Ernesto311203/PE1_Wearable/README.md

# PE1_Wearable
Codigos utilizados para el arduino y creación de la aplicación.
13/08/2025: Se adicionan esquemáticos, footprints, símbolos y modelos 3D para KiCAD (trabajado en KiCAD 9).
