Ernesto311203/PE1_Wearable/Mezzanine_PCB_B2B/Pinout_NINA.png

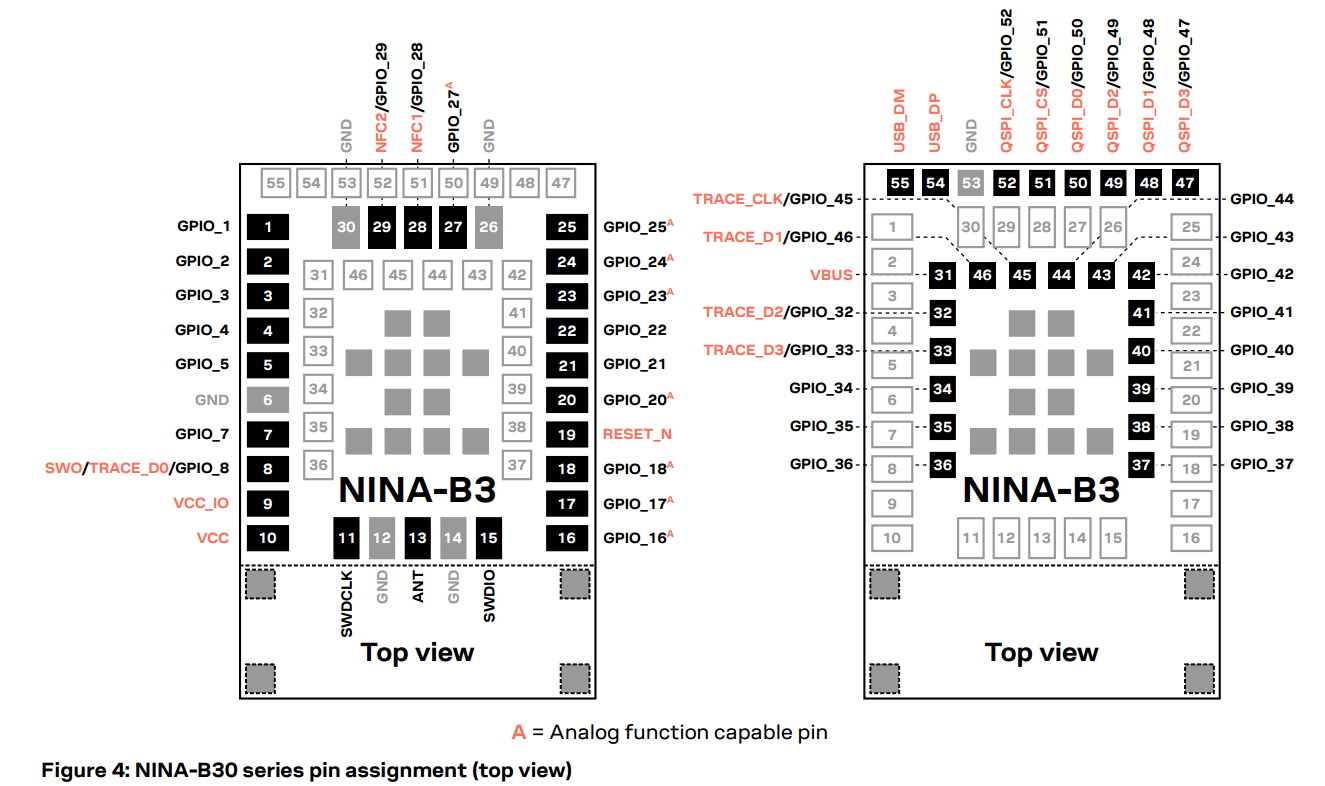
Mezzanine_PCB_B2B/Pinout_NINA.png
