Ernesto311203/PE1_Wearable/Mezzanine_PCB_B2B/Switch_image.png

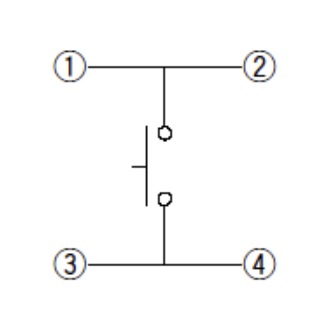
Mezzanine_PCB_B2B/Switch_image.png
