Ernesto311203/PE1_Wearable/Mezzanine_PCB_B2B/bom-JLCPCB Assembly Order.xls

JLCPCB BOM Tool - BOM Matching
BOM name：bom-JLCPCB Assembly Order.xlsx |  |  | Download Time：2025-08-21 18:07:15 |  |  |  | * Our matching results are updated in real-time, but stock and prices may change. If it's been over 24 hours, please re-match before placing your order.
PCB Assembled Qty：5 |  |  | Est. Total Price：75.5885
Your BOM |  |  |  |  | Matched Parts |  |  |  |  |  |  | Order Information
Top Designator | Bottom Designator | Comment | Footprint | JLCPCB Part # | Matches | Part # | Manufacturer | Footprint | Description | Category | Warning | JLCPCB Part # | Product link | Lib Type | Qty | Source | Total Price ($)
BT1 |  | 2996 | BAT_2996 |  | Select by System | 2996 | Keystone | - | - Battery connector ROHS | Battery Connector |  | C5370874 | https://jlcpcb.com/partdetail/Keystone-2996/C5370874 | Extended | 2 | 2 JLCPCB | 1.305
C1,C10,C11,C12,C9 |  | 10u | 0402 |  | Unconfirmed | CL05A106MQ5NUNC | Samsung Electro-Mechanics | 0402 | 10uF 6.3V X5R ±20% 0402 Multilayer Ceramic Capacitors MLCC - SMD/SMT ROHS | Multilayer Ceramic Capacitors MLCC - SMD/SMT | 1.The comment (CL05A106MQ5NUNC) of this part does not match the one (10u) provided in your BOM. Please confirm; | C15525 | https://jlcpcb.com/partdetail/16204-CL05A106MQ5NUNC/C15525 | Basic | 20 | 20 JLCPCB | 0.118
C2,C4,C6 |  | 100n | 0603 |  | Unconfirmed | CC0603KRX7R9BB104 | YAGEO | 0603 | 100nF 50V X7R ±10% 0603 Multilayer Ceramic Capacitors MLCC - SMD/SMT ROHS | Multilayer Ceramic Capacitors MLCC - SMD/SMT | 1.The comment (CC0603KRX7R9BB104) of this part does not match the one (100n) provided in your BOM. Please confirm; | C14663 | https://jlcpcb.com/partdetail/YAGEO-CC0603KRX7R9BB104/C14663 | Basic | 20 | 20 JLCPCB | 0.046
C3,C5,C7 |  | 10n | 0603 |  | Unconfirmed | 0603B103K500NT | FH (Guangdong Fenghua Advanced Tech) | 0603 | 10nF 50V X7R ±10% 0603 Multilayer Ceramic Capacitors MLCC - SMD/SMT ROHS | Multilayer Ceramic Capacitors MLCC - SMD/SMT | 1.The comment (0603B103K500NT) of this part does not match the one (10n) provided in your BOM. Please confirm; | C57112 | https://jlcpcb.com/partdetail/58143-0603B103K500NT/C57112 | Basic | 20 | 20 JLCPCB | 0.044
C13,C14 |  | 1u | 0402 |  | Unconfirmed | CL05A105KA5NQNC | Samsung Electro-Mechanics | 0402 | 1uF 25V X5R ±10% 0402 Multilayer Ceramic Capacitors MLCC - SMD/SMT ROHS | Multilayer Ceramic Capacitors MLCC - SMD/SMT | 1.The comment (CL05A105KA5NQNC) of this part does not match the one (1u) provided in your BOM. Please confirm; | C52923 | https://jlcpcb.com/partdetail/53938-CL05A105KA5NQNC/C52923 | Basic | 20 | 20 JLCPCB | 0.06
C15 |  | 220n(5%) | 0402 |  | Unconfirmed | GRM155R61A224JE19D | Murata Electronics | 0402 | 10V 220nF X5R ±5% 0402 Multilayer Ceramic Capacitors MLCC - SMD/SMT ROHS | Multilayer Ceramic Capacitors MLCC - SMD/SMT | 1.The comment (GRM155R61A224JE19D) of this part does not match the one (220n(5%)) provided in your BOM. Please confirm; | C882536 | https://jlcpcb.com/partdetail/946643-GRM155R61A224JE19D/C882536 | Extended | 20 | 20 JLCPCB | 0.592
C16,C18,C36,C38,C40,C8 |  | 10u(5%) | 0402 |  | Select by Customer | GRM155R61A106ME44D | Murata Electronics | 0402 | 10V 10uF X5R ±20% 0402 Multilayer Ceramic Capacitors MLCC - SMD/SMT ROHS | Multilayer Ceramic Capacitors MLCC - SMD/SMT |  | C77000 | https://jlcpcb.com/partdetail/MurataElectronics-GRM155R61A106ME44D/C77000 | Extended | 24 | 24 JLCPCB | 0.2712
C17,C19,C21,C22,C23,C28,C32,C33,C35,C37,C39,C41,C42,C43,C44 |  | 100n(5%) | 0402 |  | Unconfirmed | CC0402JRX7R9BB104 | YAGEO | 0402 | 100nF 50V X7R ±5% 0402 Multilayer Ceramic Capacitors MLCC - SMD/SMT ROHS | Multilayer Ceramic Capacitors MLCC - SMD/SMT | 1.The comment (CC0402JRX7R9BB104) of this part does not match the one (100n(5%)) provided in your BOM. Please confirm; | C5182432 | https://jlcpcb.com/partdetail/YAGEO-CC0402JRX7R9BB104/C5182432 | Extended | 42 | 42 JLCPCB | 0.1848
C20,C31 |  | 2.2u(5%) | 0402 |  | Select by Customer | GRM155R61A225KE95D | Murata Electronics | 0402 | 10V 2.2uF X5R ±10% 0402 Multilayer Ceramic Capacitors MLCC - SMD/SMT ROHS | Multilayer Ceramic Capacitors MLCC - SMD/SMT |  | C77002 | https://jlcpcb.com/partdetail/MurataElectronics-GRM155R61A225KE95D/C77002 | Extended | 20 | 20 JLCPCB | 0.082
C24,C25,C26,C27,C29,C30 |  | 1u(5%) | 0402 |  | Unconfirmed | C0402X5R6R3-105JNP | Venkel | 0402 | 1uF 6.3V X5R ±5% 0402 Multilayer Ceramic Capacitors MLCC - SMD/SMT ROHS | Multilayer Ceramic Capacitors MLCC - SMD/SMT | 1.The comment (C0402X5R6R3-105JNP) of this part does not match the one (1u(5%)) provided in your BOM. Please confirm; | C3892343 | https://jlcpcb.com/partdetail/Venkel-C0402X5R6R3105JNP/C3892343 | Extended | 22 | 22 JLCPCB | 0.3608
C34 |  | 3.9p(5%) | 0402 |  | Select by Customer | GJM1555C1H3R9WB01D | Murata Electronics | 0402 | 3.9pF 50V C0G 0402 Multilayer Ceramic Capacitors MLCC - SMD/SMT ROHS | Multilayer Ceramic Capacitors MLCC - SMD/SMT |  | C88893 | https://jlcpcb.com/partdetail/MurataElectronics-GJM1555C1H3R9WB01D/C88893 | Extended | 20 | 20 JLCPCB | 0.774
D1,D2 |  | SML-P11UTT86R | LED_SML-P11UTT86R |  | Select by System | SML-P11UTT86R | ROHM Semicon | 0402 | -40℃~+85℃ 1.8V 1mA 2.5mcd 50mW 621nm Orange Red 0402 LED Indication - Discrete ROHS | LED Indication - Discrete |  | C510300 | https://jlcpcb.com/partdetail/ROHMSemicon-SMLP11UTT86R/C510300 | Extended | 7 | 7 JLCPCB | 0.7427
IC1 |  | TMP117AIDRVR | SON65P200X200X80-7N |  | Select by System | TMP117AIDRVR | Texas Instruments | WDFN-6-EP(2x2) | WDFN-6-EP(2x2) Temperature Sensors ROHS | Temperature Sensors |  | C699536 | https://jlcpcb.com/partdetail/TexasInstruments-TMP117AIDRVR/C699536 | Extended | 2 | 2 JLCPCB | 2.211
J1 |  | 702461001 | CONN_7024610xx_MOL |  | Select by System | 702461001 | MOLEX | - | - Wire To Board Connector ROHS | Wire To Board Connector |  | C588425 | https://jlcpcb.com/partdetail/MOLEX-702461001/C588425 | Extended | 2 | 2 JLCPCB | 1.956
J2 |  | Conn_02x02_Counter_Clockwise | PinHeader_2x02_P1.27mm_Vertical |  | Select by Customer | X1321WV-2x02J-C30D23 | XKB Connection | 插件,P=1.27mm | -40℃~+105℃ 1.27mm 1.27mm 1A 1mm 2 250V 2x2P 4P Black Brass Gold Pin Header Plugin,P=1.27mm Pin Headers ROHS | Pin Headers |  | C2881784 | https://jlcpcb.com/partdetail/XKBConnection-X1321WV_2x02JC30D23/C2881784 | Extended | 3 | 3 JLCPCB | 0.168
J3,J4 |  | 203389-0363 | 2033890363 |  | Select by System | 2033890363 | MOLEX | SMD,P=0.35mm | 0.35mm 2 36P Gold Surface Mount,Vertical SMD,P=0.35mm Board-to-Board and Backplane Connector ROHS | Board-To-Board And Backplane Connector |  | C5491435 | https://jlcpcb.com/partdetail/MOLEX-2033890363/C5491435 | Extended | 4 | 4 JLCPCB | 5.394
L1 |  | MLZ2012M100HT000 | INDC2012X145N |  | Select by System | MLZ2012M100HT000 | TDK | 0805 | 10uH 200mA 680mΩ ±20% 0805 Inductors (SMD) ROHS | Inductors (SMD) |  | C88172 | https://jlcpcb.com/partdetail/TDK-MLZ2012M100HT000/C88172 | Extended | 6 | 6 JLCPCB | 0.2748
L2 |  | LBM2016T6R8J | INDC2016X180N_6_8uH |  | Select by Customer | MLZ2012M6R8WT000 | TDK | 0805 | 220mA 400mΩ 6.8uH ±20% 0805 Inductors (SMD) ROHS | Inductors (SMD) | 1.The comment (MLZ2012M6R8WT000) of this part does not match the one (LBM2016T6R8J) provided in your BOM. Please confirm; | C383410 | https://jlcpcb.com/partdetail/TDK-MLZ2012M6R8WT000/C383410 | Extended | 6 | 6 JLCPCB | 0.3006
 | LED1,LED3,LED4 | SFH_2202 | SFH2202 |  | Select by Customer | SFH 2200 | OSRAM Opto Semicon | SMD,4x5.1mm | SMD,4x5.1mm Photodiodes ROHS | Photodiodes | 1.The comment (SFH 2200) of this part does not match the one (SFH_2202) provided in your BOM. Please confirm; | C2900212 | https://jlcpcb.com/partdetail/OSRAM_OptoSemicon-SFH2200/C2900212 | Extended | 6 | 6 JLCPCB | 5.715
 | LED2 | SFH_7050A | SFH7050A |  | Unconfirmed | SFH 7050A | OSRAM Opto Semicon | SMD-8P | -40℃~+85℃ 1.3V 120° 2mW/sr@20mA 5V 60mA 940nm SMD-8P Infrared LED Emitters ROHS | Infrared LED Emitters | 1.The comment (SFH 7050A) of this part does not match the one (SFH_7050A) provided in your BOM. Please confirm; | C7357545 | https://jlcpcb.com/partdetail/OSRAM_OptoSemicon-SFH7050A/C7357545 | Extended | 2 | 2 JLCPCB | 6.132
Q2 |  | NX6008NBKSX | SOT65P210X110-6N |  | Select by System | NX6008NBKSX | Nexperia | TSSOP-6 | -55℃~+150℃ 2 N-Channel 2.7Ω@4.5V,300mA 220mA 260mW 27pF@30V 2pF@30V 60V 700pC@4.5V 900mV TSSOP-6 MOSFETs ROHS | MOSFETs |  | C3291378 | https://jlcpcb.com/partdetail/Nexperia-NX6008NBKSX/C3291378 | Extended | 5 | 5 JLCPCB | 0.379
R1 |  | 39R | 0402 |  | Unconfirmed | RC0402FR-0739RL | YAGEO | 0402 | -55℃~+155℃ 39Ω 50V 62.5mW Thick Film Resistor ±1% ±100ppm/℃ 0402 Chip Resistor - Surface Mount ROHS | Chip Resistor - Surface Mount | 1.The comment (RC0402FR-0739RL) of this part does not match the one (39R) provided in your BOM. Please confirm; | C185420 | https://jlcpcb.com/partdetail/YAGEO-RC0402FR0739RL/C185420 | Extended | 20 | 20 JLCPCB | 0.012
R2,R3 |  | 1k | 0402 |  | Unconfirmed | 0402WGF1001TCE | UNI-ROYAL(Uniroyal Elec) | 0402 | -55℃~+155℃ 1kΩ 50V 62.5mW Thick Film Resistor ±1% ±100ppm/℃ 0402 Chip Resistor - Surface Mount ROHS | Chip Resistor - Surface Mount | 1.The comment (0402WGF1001TCE) of this part does not match the one (1k) provided in your BOM. Please confirm; | C11702 | https://jlcpcb.com/partdetail/12256-0402WGF1001TCE/C11702 | Basic | 20 | 20 JLCPCB | 0.01
R4 |  | 0R | 0402 |  | Unconfirmed | 0402WGF0000TCE | UNI-ROYAL(Uniroyal Elec) | 0402 | -55℃~+155℃ 0Ω 50V 62.5mW Thick Film Resistor ±1% ±800ppm/℃ 0402 Chip Resistor - Surface Mount ROHS | Chip Resistor - Surface Mount | 1.The comment (0402WGF0000TCE) of this part does not match the one (0R) provided in your BOM. Please confirm; | C17168 | https://jlcpcb.com/partdetail/17853-0402WGF0000TCE/C17168 | Basic | 20 | 20 JLCPCB | 0.01
R5 |  | 10k | 0402 |  | Unconfirmed | 0402WGF1002TCE | UNI-ROYAL(Uniroyal Elec) | 0402 | -55℃~+155℃ 10kΩ 50V 62.5mW Thick Film Resistor ±1% ±100ppm/℃ 0402 Chip Resistor - Surface Mount ROHS | Chip Resistor - Surface Mount | 1.The comment (0402WGF1002TCE) of this part does not match the one (10k) provided in your BOM. Please confirm; | C25744 | https://jlcpcb.com/partdetail/26487-0402WGF1002TCE/C25744 | Basic | 20 | 20 JLCPCB | 0.01
R6 |  | 162k(1%) | 0402 |  | Unconfirmed | RT0402BRD07162KL | YAGEO | 0402 | -55℃~+155℃ 162kΩ 50V 62.5mW Thin Film Resistor ±0.1% ±25ppm/℃ 0402 Chip Resistor - Surface Mount ROHS | Chip Resistor - Surface Mount | 1.The comment (RT0402BRD07162KL) of this part does not match the one (162k(1%)) provided in your BOM. Please confirm; | C852551 | https://jlcpcb.com/partdetail/YAGEO-RT0402BRD07162KL/C852551 | Extended | 20 | 20 JLCPCB | 0.454
R7 |  | 180k(1%) | 0402 |  | Unconfirmed | FRC0402F1803TS | FOJAN | 0402 | -55℃~+155℃ 180kΩ 50V 62.5mW Thick Film Resistor ±1% ±100ppm/℃ 0402 Chip Resistor - Surface Mount ROHS | Chip Resistor - Surface Mount | 1.The comment (FRC0402F1803TS) of this part does not match the one (180k(1%)) provided in your BOM. Please confirm; | C2909325 | https://jlcpcb.com/partdetail/FOJAN-FRC0402F1803TS/C2909325 | Extended | 20 | 20 JLCPCB | 0.01
R8 |  | 540k(1%) | 0402 |  | Select by Customer | 0402WGF5363TCE | UNI-ROYAL(Uniroyal Elec) | 0402 | -55℃~+155℃ 50V 536kΩ 62.5mW Thick Film Resistor ±1% ±100ppm/℃ 0402 Chip Resistor - Surface Mount ROHS | Chip Resistor - Surface Mount |  | C68457 | https://jlcpcb.com/partdetail/69559-0402WGF5363TCE/C68457 | Extended | 20 | 20 JLCPCB | 0.006
R11,R9 |  | 1Meg(1%) | 0402 |  | Unconfirmed | FRC0402F1004TS | FOJAN | 0402 | -55℃~+155℃ 1MΩ 50V 62.5mW Thick Film Resistor ±1% ±100ppm/℃ 0402 Chip Resistor - Surface Mount ROHS | Chip Resistor - Surface Mount | 1.The comment (FRC0402F1004TS) of this part does not match the one (1Meg(1%)) provided in your BOM. Please confirm; | C2909328 | https://jlcpcb.com/partdetail/FOJAN-FRC0402F1004TS/C2909328 | Extended | 20 | 20 JLCPCB | 0.01
R12 |  | 0R(1%) | 0402 |  | Unconfirmed | SCR0402F0R | VO | 0402 | -55℃~+155℃ 0Ω 50V 62.5mW Thick Film Resistor ±1% 0402 Chip Resistor - Surface Mount ROHS | Chip Resistor - Surface Mount | 1.The comment (SCR0402F0R) of this part does not match the one (0R(1%)) provided in your BOM. Please confirm; | C5140078 | https://jlcpcb.com/partdetail/VO-SCR0402F0R/C5140078 | Extended | 20 | 20 JLCPCB | 0.008
R14,R15,R16 |  | 5k1(1%) | 0402 |  | Unconfirmed | RT0402BRD075K1L | YAGEO | 0402 | -55℃~+155℃ 5.1kΩ 50V 62.5mW Thin Film Resistor ±0.1% ±25ppm/℃ 0402 Chip Resistor - Surface Mount ROHS | Chip Resistor - Surface Mount | 1.The comment (RT0402BRD075K1L) of this part does not match the one (5k1(1%)) provided in your BOM. Please confirm; | C852856 | https://jlcpcb.com/partdetail/YAGEO-RT0402BRD075K1L/C852856 | Extended | 20 | 20 JLCPCB | 0.376
R13_2 |  | 750k(1%) | 0402 |  | Select by Customer | RC0402FR-07750KL | YAGEO | 0402 | -55℃~+155℃ 50V 62.5mW 750kΩ Thick Film Resistor ±1% ±100ppm/℃ 0402 Chip Resistor - Surface Mount ROHS | Chip Resistor - Surface Mount |  | C137937 | https://jlcpcb.com/partdetail/YAGEO-RC0402FR07750KL/C137937 | Extended | 20 | 20 JLCPCB | 0.012
S1,S2 |  | SKRPABE010 | SKRPABE010 |  | Select by System | SKRPABE010 | ALPSALPINE | SMD | 16V 2.5mm 3.2mm 4.2mm 50mA Oval Button SPST Surface Mount,Vertical SMD Tactile Switches ROHS | Tactile Switches |  | C115360 | https://jlcpcb.com/partdetail/ALPSALPINE-SKRPABE010/C115360 | Extended | 8 | 8 JLCPCB | 0.5472
S3 |  | PCM12SMTR | PCM12SMTR |  | Select by System | PCM12SMTR | C&K | SMD | -20℃~+85℃ 6V PC Pin Rectangular Columnar SPDT Surface Mount,Vertical SMD Slide Switches ROHS | Slide Switches |  | C221841 | https://jlcpcb.com/partdetail/CK-PCM12SMTR/C221841 | Extended | 2 | 2 JLCPCB | 2.328
U3,U4 |  | TPS61071DDCR | SOT95P280X110-6N |  | Select by System | TPS61071DDCR | Texas Instruments | SOT-23-6 | -40℃~+85℃@(TA) 1 1.2MHz 1.8V~5.5V 500mA 900mV~5.5V Adjustable Boost Boost Built-in Yes SOT-23-6 DC-DC Converters ROHS | DC-DC Converters |  | C188637 | https://jlcpcb.com/partdetail/TexasInstruments-TPS61071DDCR/C188637 | Extended | 4 | 4 JLCPCB | 1.758
U5 |  | TPS73215MDBVREP | DBV5 |  | Select by Customer | TPS73215DCQR | Texas Instruments | SOT-223-6 | -40℃~+125℃@(Tj) 1 1.5V 250mA 30uVrms 400uA 40mV@(250mA) 5.5V 58dB@(100Hz) Fixed Over Current Protection Positive SOT-223-6 Voltage Regulators - Linear, Low Drop Out (LDO) Regulators ROHS | Voltage Regulators - Linear, Low Drop Out (LDO) Regulators |  | C2865336 | https://jlcpcb.com/partdetail/TexasInstruments-TPS73215DCQR/C2865336 | Extended | 2 | 2 JLCPCB | 4.29
U6,U7 |  | TPS7A2018PDBVR | DBV0005A-IPC_A |  | Select by System | TPS7A2018PDBVR | Texas Instruments | SOT-23-5L | -40℃~+125℃@(Tj) 1 1.8V 10uVrms 200mV@(300mA) 300mA 6.5uA 6V 92dB@(1kHz) Fixed Positive Under Voltage Lockout SOT-23-5L Voltage Regulators - Linear, Low Drop Out (LDO) Regulators ROHS | Voltage Regulators - Linear, Low Drop Out (LDO) Regulators |  | C963430 | https://jlcpcb.com/partdetail/TexasInstruments-TPS7A2018PDBVR/C963430 | Extended | 4 | 4 JLCPCB | 0.7904
U8 |  | TPS7A2033PDBVR | DBV0005A-IPC_A |  | Select by System | TPS7A2033PDBVR | Texas Instruments | SOT-23-5 | -40℃~+125℃@(Tj) 1 10uVrms 140mV@(300mA) 3.3V 300mA 65dB@(100kHz) 6V 8.5uA Fixed Over Current Protection Positive SOT-23-5 Voltage Regulators - Linear, Low Drop Out (LDO) Regulators ROHS | Voltage Regulators - Linear, Low Drop Out (LDO) Regulators |  | C2862740 | https://jlcpcb.com/partdetail/TexasInstruments-TPS7A2033PDBVR/C2862740 | Extended | 5 | 5 JLCPCB | 0.859
U9 |  | ADP7118AUJZ-R7 | UJ_5_ADI |  | Select by System | ADP7118AUJZ-R7 | Analog Devices | TSOT-5 | -40℃~+125℃@(Tj) 1 1.2V~19.8V 11uVrms 140uA 200mA 20V 420mV@(200mA) 88dB@(10kHz) Adjustable Over Current Protection Positive TSOT-5 Voltage Regulators - Linear, Low Drop Out (LDO) Regulators ROHS | Voltage Regulators - Linear, Low Drop Out (LDO) Regulators |  | C514355 | https://jlcpcb.com/partdetail/AnalogDevices-ADP7118AUJZR7/C514355 | Extended | 2 | 2 JLCPCB | 3.336
U10 |  | NINA-B306-00B | XCVR_NINA-B306-00B |  | Select by System | NINA-B306-00B | U-BLOX | SMD-55P | SMD-55P Bluetooth Modules ROHS | Bluetooth Modules |  | C6127317 | https://jlcpcb.com/partdetail/UBLOX-NINA_B30600B/C6127317 | Extended | 2 | 2 JLCPCB | 33.264
Y1 |  | SIT9003AC-23-18EB-24.000000T | OSC_SIT9003AC-23-18EB-24.000000T |  | Select by Customer | X322512MSB4SI | YXC Crystal Oscillators | SMD3225-4P | -40℃~+85℃ 12MHz 20pF Crystal Oscillator ±10ppm ±20ppm SMD3225-4P Crystals ROHS | Crystals | 1.The comment (X322512MSB4SI) of this part does not match the one (SIT9003AC-23-18EB-24.000000T) provided in your BOM. Please confirm; | C9002 | https://jlcpcb.com/partdetail/YXC_CrystalOscillators-X322512MSB4SI/C9002 | Basic | 6 | 6 JLCPCB | 0.387
R13 |  | 500k(1%) | 0402 |  | No matches | No Part Selected
