Ernesto311203/PE1_Wearable/Side_PCB/PCB/production/bom-JLCPCB Assembly Order.xls

JLCPCB BOM Tool - BOM Matching
BOM name：bom-JLCPCB Assembly Order.xlsx |  |  | Download Time：2025-08-20 04:47:17 |  |  |  | * Our matching results are updated in real-time, but stock and prices may change. If it's been over 24 hours, please re-match before placing your order.
PCB Assembled Qty：5 |  |  | Est. Total Price：51.7565
Your BOM |  |  |  |  | Matched Parts |  |  |  |  |  |  | Order Information
Top Designator | Bottom Designator | Comment | Footprint | JLCPCB Part # | Matches | Part # | Manufacturer | Footprint | Description | Category | Warning | JLCPCB Part # | Product link | Lib Type | Qty | Source | Total Price ($)
C1,C32,C33,C4 |  | 100n(5%) | 0402 |  | Unconfirmed | CC0402JRX7R9BB104 | YAGEO | 0402 | 100nF 50V X7R ±5% 0402 Multilayer Ceramic Capacitors MLCC - SMD/SMT ROHS | Multilayer Ceramic Capacitors MLCC - SMD/SMT | 1.The comment (CC0402JRX7R9BB104) of this part does not match the one (100n(5%)) provided in your BOM. Please confirm; | C5182432 | https://jlcpcb.com/partdetail/YAGEO-CC0402JRX7R9BB104/C5182432 | Extended | 20 | 20 JLCPCB | 0.088
C2 |  | 4.7u(5%) | 0402 |  | Select by Customer | CL05A475MP5NRNC | Samsung Electro-Mechanics | 0402 | 10V 4.7uF X5R ±20% 0402 Multilayer Ceramic Capacitors MLCC - SMD/SMT ROHS | Multilayer Ceramic Capacitors MLCC - SMD/SMT |  | C23733 | https://jlcpcb.com/partdetail/24469-CL05A475MP5NRNC/C23733 | Basic | 20 | 20 JLCPCB | 0.096
C3 |  | 10n(5%) | 0402 |  | Unconfirmed | 0402B103J500NT | FH (Guangdong Fenghua Advanced Tech) | 0402 | 10nF 50V X7R ±5% 0402 Multilayer Ceramic Capacitors MLCC - SMD/SMT ROHS | Multilayer Ceramic Capacitors MLCC - SMD/SMT | 1.The comment (0402B103J500NT) of this part does not match the one (10n(5%)) provided in your BOM. Please confirm; | C2894324 | https://jlcpcb.com/partdetail/3128847-0402B103J500NT/C2894324 | Extended | 20 | 20 JLCPCB | 0.034
C10,C11,C12,C15,C16,C17,C18,C7,C8,C9 |  | 1u(5%) | 0402 |  | Unconfirmed | C0402X5R6R3-105JNP | Venkel | 0402 | 1uF 6.3V X5R ±5% 0402 Multilayer Ceramic Capacitors MLCC - SMD/SMT ROHS | Multilayer Ceramic Capacitors MLCC - SMD/SMT | 1.The comment (C0402X5R6R3-105JNP) of this part does not match the one (1u(5%)) provided in your BOM. Please confirm; | C3892343 | https://jlcpcb.com/partdetail/Venkel-C0402X5R6R3105JNP/C3892343 | Extended | 30 | 30 JLCPCB | 0.492
C34 |  | 3.9p(5%) | 0402 |  | Select by Customer | 0402CG3R9C500NT | FH (Guangdong Fenghua Advanced Tech) | 0402 | 3.9pF 50V C0G 0402 Multilayer Ceramic Capacitors MLCC - SMD/SMT ROHS | Multilayer Ceramic Capacitors MLCC - SMD/SMT |  | C1566 | https://jlcpcb.com/partdetail/1918-0402CG3R9C500NT/C1566 | Extended | 20 | 20 JLCPCB | 0.022
D1 |  | PRTR5V0U2X | SOT-143 |  | Select by System | PRTR5V0U2X | TECH PUBLIC | SOT-143 | -55℃~+125℃ 0.8pF 100W 15V 3.0 5V 6.5V 6A 80nA ESD IEC 61000-4-2 Unidirectional SOT-143 ESD and Surge Protection (TVS/ESD) ROHS | ESD And Surge Protection (TVS/ESD) |  | C2827688 | https://jlcpcb.com/partdetail/TECHPUBLIC-PRTR5V0U2X/C2827688 | Extended | 6 | 6 JLCPCB | 0.354
FB1,FB2 |  | PE-0805FB121ST | BEADC2112X105N |  | Select by Customer | GZ2012D121TF | Sunlord | 0805 | 1 120Ω@100MHz 150mΩ 800mA ±25% 0805 Ferrite Beads ROHS | Ferrite Beads |  | C5671 | https://jlcpcb.com/partdetail/Sunlord-GZ2012D121TF/C5671 | Extended | 20 | 20 JLCPCB | 0.264
IC1,IC2 |  | TLV75101PDSQR | SON40P200X200X80-11N |  | Select by System | TLV75101PDSQR | Texas Instruments | WSON-10-EP(2x2) | -40℃~+125℃@(Tj) 130mV@(500mA) 2 25uA 30uVrms 500mA 50dB@(1kHz) 550mV~5.5V 6V Adjustable Positive Under Voltage Lockout WSON-10-EP(2x2) Voltage Regulators - Linear, Low Drop Out (LDO) Regulators ROHS | Voltage Regulators - Linear, Low Drop Out (LDO) Regulators |  | C2861335 | https://jlcpcb.com/partdetail/TexasInstruments-TLV75101PDSQR/C2861335 | Extended | 5 | 5 JLCPCB | 1.571
J1 |  | SHF-110-01-L-D-TH | SAMTEC_SHF-110-01-L-D-TH |  | Select by System | SHF-110-01-L-D-TH | Samtec | 插件 | -55℃~+125℃ 1.27mm 2 Phosphor Bronze Through Hole Tin Plugin Wire To Board Connector ROHS | Wire To Board Connector |  | C17455319 | https://jlcpcb.com/partdetail/Samtec-SHF_110_01_L_DTH/C17455319 | Extended | 2 | 2 JLCPCB | 9.291
J2 |  | Conn_02x02_Counter_Clockwise | PinHeader_2x02_P1.27mm_Vertical |  | Select by Customer | X1321WV-2x02J-C30D23 | XKB Connection | 插件,P=1.27mm | -40℃~+105℃ 1.27mm 1.27mm 1A 1mm 2 250V 2x2P 4P Black Brass Gold Pin Header Plugin,P=1.27mm Pin Headers ROHS | Pin Headers |  | C2881784 | https://jlcpcb.com/partdetail/XKBConnection-X1321WV_2x02JC30D23/C2881784 | Extended | 3 | 3 JLCPCB | 0.168
J3 |  | USB_C_Receptacle16P | USB_C_Receptacle16P_Molex |  | Select by Customer | 2171790001 | MOLEX | SMD | SMD USB Connectors ROHS | USB Connectors |  | C3197684 | https://jlcpcb.com/partdetail/MOLEX-2171790001/C3197684 | Extended | 2 | 2 JLCPCB | 1.299
J6 |  | Conn_01x06_Pin | PinHeader_1x06_P1.27mm_Vertical |  | Select by Customer | PZ127-1-06-Z | HCTL | 插件,P=1.27mm | -40℃~+105℃ 1 1.27mm 1A 1mm 1x6P 2.4mm 3.8mm 6P Black Brass Pin Header Through Hole Plugin,P=1.27mm Pin Headers ROHS | Pin Headers |  | C5372829 | https://jlcpcb.com/partdetail/HCTL-PZ127_1_06Z/C5372829 | Extended | 2 | 2 JLCPCB | 0.1302
LED5,LED6 |  | SML-P11UTT86R | KDZLV100 |  | Select by System | SML-P11UTT86R | ROHM Semicon | 0402 | -40℃~+85℃ 1.8V 1mA 2.5mcd 50mW 621nm Orange Red 0402 LED Indication - Discrete ROHS | LED Indication - Discrete |  | C510300 | https://jlcpcb.com/partdetail/ROHMSemicon-SMLP11UTT86R/C510300 | Extended | 7 | 7 JLCPCB | 0.7427
Q1 |  | NX138AKSX | NX138AKSX |  | Select by Customer | NX6008NBKSX | Nexperia | TSSOP-6 | -55℃~+150℃ 2 N-Channel 2.7Ω@4.5V,300mA 220mA 260mW 27pF@30V 2pF@30V 60V 700pC@4.5V 900mV TSSOP-6 MOSFETs ROHS | MOSFETs | 1.The comment (NX6008NBKSX) of this part does not match the one (NX138AKSX) provided in your BOM. Please confirm; | C3291378 | https://jlcpcb.com/partdetail/Nexperia-NX6008NBKSX/C3291378 | Extended | 5 | 5 JLCPCB | 0.379
R1,R2 |  | 5k1(1%) | 0402 |  | Unconfirmed | RT0402BRD075K1L | YAGEO | 0402 | -55℃~+155℃ 5.1kΩ 50V 62.5mW Thin Film Resistor ±0.1% ±25ppm/℃ 0402 Chip Resistor - Surface Mount ROHS | Chip Resistor - Surface Mount | 1.The comment (RT0402BRD075K1L) of this part does not match the one (5k1(1%)) provided in your BOM. Please confirm; | C852856 | https://jlcpcb.com/partdetail/YAGEO-RT0402BRD075K1L/C852856 | Extended | 20 | 20 JLCPCB | 0.376
R4,R6 |  | 220k(1%) | 0402 |  | Select by Customer | RC0402FR-07330KL | YAGEO | 0402 | -55℃~+155℃ 330kΩ 50V 62.5mW Thick Film Resistor ±1% ±100ppm/℃ 0402 Chip Resistor - Surface Mount ROHS | Chip Resistor - Surface Mount | 1.The comment (RC0402FR-07330KL) of this part does not match the one (220k(1%)) provided in your BOM. Please confirm; | C138006 | https://jlcpcb.com/partdetail/YAGEO-RC0402FR07330KL/C138006 | Extended | 20 | 20 JLCPCB | 0.012
R7,R9 |  | 1.2Meg(1%) | 0402 |  | Unconfirmed | FRC0402F1204TS | FOJAN | 0402 | -55℃~+155℃ 1.2MΩ 50V 62.5mW Thick Film Resistor ±1% ±100ppm/℃ 0402 Chip Resistor - Surface Mount ROHS | Chip Resistor - Surface Mount | 1.The comment (FRC0402F1204TS) of this part does not match the one (1.2Meg(1%)) provided in your BOM. Please confirm; | C2960795 | https://jlcpcb.com/partdetail/FOJAN-FRC0402F1204TS/C2960795 | Extended | 20 | 20 JLCPCB | 0.012
R10,R8 |  | 240k(1%) | 0402 |  | Unconfirmed | FRC0402F2403TS | FOJAN | 0402 | -55℃~+155℃ 240kΩ 50V 62.5mW Thick Film Resistor ±1% ±100ppm/℃ 0402 Chip Resistor - Surface Mount ROHS | Chip Resistor - Surface Mount | 1.The comment (FRC0402F2403TS) of this part does not match the one (240k(1%)) provided in your BOM. Please confirm; | C2909338 | https://jlcpcb.com/partdetail/FOJAN-FRC0402F2403TS/C2909338 | Extended | 20 | 20 JLCPCB | 0.008
R12 |  | 0R(1%) | 0402 |  | Unconfirmed | SCR0402F0R | VO | 0402 | -55℃~+155℃ 0Ω 50V 62.5mW Thick Film Resistor ±1% 0402 Chip Resistor - Surface Mount ROHS | Chip Resistor - Surface Mount | 1.The comment (SCR0402F0R) of this part does not match the one (0R(1%)) provided in your BOM. Please confirm; | C5140078 | https://jlcpcb.com/partdetail/VO-SCR0402F0R/C5140078 | Extended | 20 | 20 JLCPCB | 0.008
R13,R3,R5 |  | 500k(1%) | 0402 |  | Select by Customer | RC0402FR-07750KL | YAGEO | 0402 | -55℃~+155℃ 50V 62.5mW 750kΩ Thick Film Resistor ±1% ±100ppm/℃ 0402 Chip Resistor - Surface Mount ROHS | Chip Resistor - Surface Mount |  | C137937 | https://jlcpcb.com/partdetail/YAGEO-RC0402FR07750KL/C137937 | Extended | 20 | 20 JLCPCB | 0.012
S2 |  | SKRPABE010 | SKRPABE010 |  | Select by System | SKRPABE010 | ALPSALPINE | SMD | 16V 2.5mm 3.2mm 4.2mm 50mA Oval Button SPST Surface Mount,Vertical SMD Tactile Switches ROHS | Tactile Switches |  | C115360 | https://jlcpcb.com/partdetail/ALPSALPINE-SKRPABE010/C115360 | Extended | 6 | 6 JLCPCB | 0.4104
S3 |  | PCM12SMTR | PCM12SMTR |  | Select by System | PCM12SMTR | C&K | SMD | -20℃~+85℃ 6V PC Pin Rectangular Columnar SPDT Surface Mount,Vertical SMD Slide Switches ROHS | Slide Switches |  | C221841 | https://jlcpcb.com/partdetail/CK-PCM12SMTR/C221841 | Extended | 2 | 2 JLCPCB | 2.328
U2 |  | TPS7A2018PDBVR | DBV0005A-IPC_A |  | Select by System | TPS7A2018PDBVR | Texas Instruments | SOT-23-5L | -40℃~+125℃@(Tj) 1 1.8V 10uVrms 200mV@(300mA) 300mA 6.5uA 6V 92dB@(1kHz) Fixed Positive Under Voltage Lockout SOT-23-5L Voltage Regulators - Linear, Low Drop Out (LDO) Regulators ROHS | Voltage Regulators - Linear, Low Drop Out (LDO) Regulators |  | C963430 | https://jlcpcb.com/partdetail/TexasInstruments-TPS7A2018PDBVR/C963430 | Extended | 2 | 2 JLCPCB | 0.3952
U10 |  | NINA-B306-00B | XCVR_NINA-B306-00B |  | Select by System | NINA-B306-00B | U-BLOX | SMD-55P | SMD-55P Bluetooth Modules ROHS | Bluetooth Modules |  | C6127317 | https://jlcpcb.com/partdetail/UBLOX-NINA_B30600B/C6127317 | Extended | 2 | 2 JLCPCB | 33.264
