Ernesto311203/PE1_Wearable/Side_PCB/nRF52840_Design.pdf

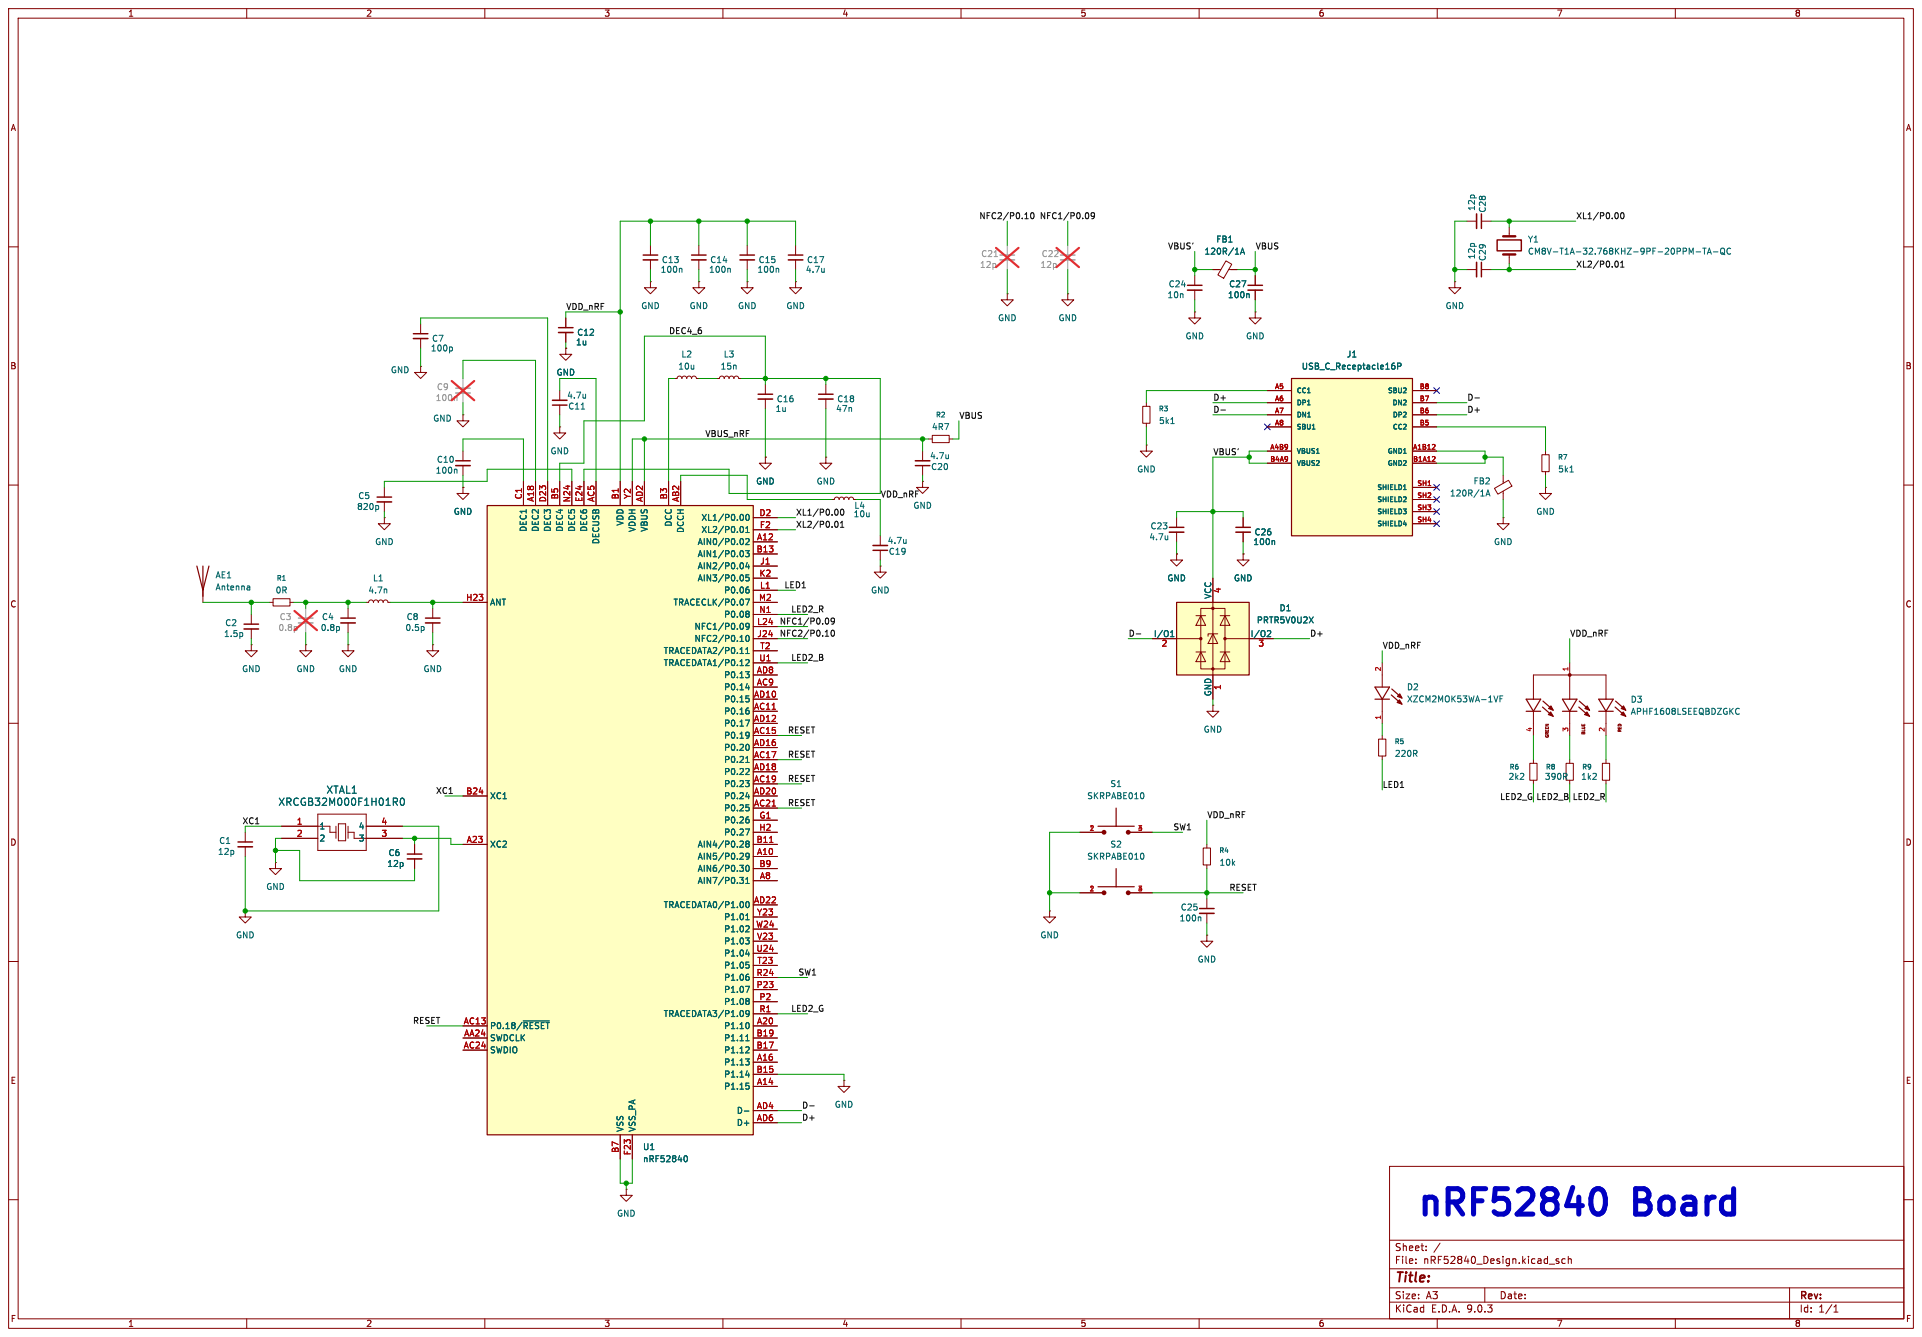
[picture p3: page 1]

Id: 1/1 Title: File: nRF52840_Design.kicad_sch Sheet: /
