Ernesto311203/PE1_Wearable/Mezzanine_PCB_B2B/WearablePCB_v2.pdf

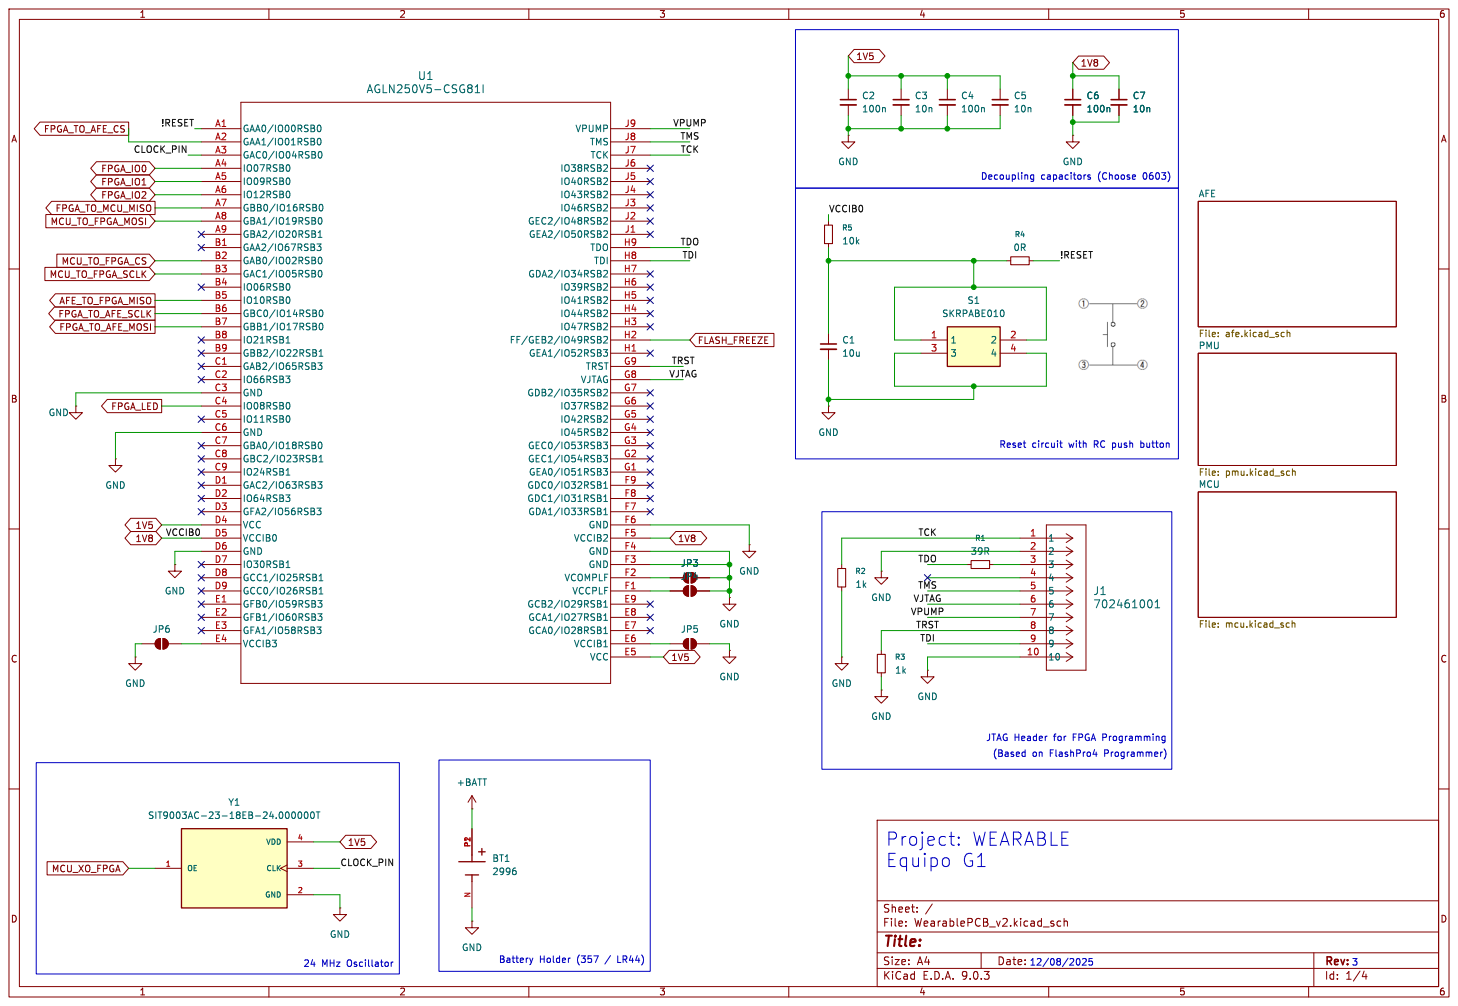
[picture p4: page 1]

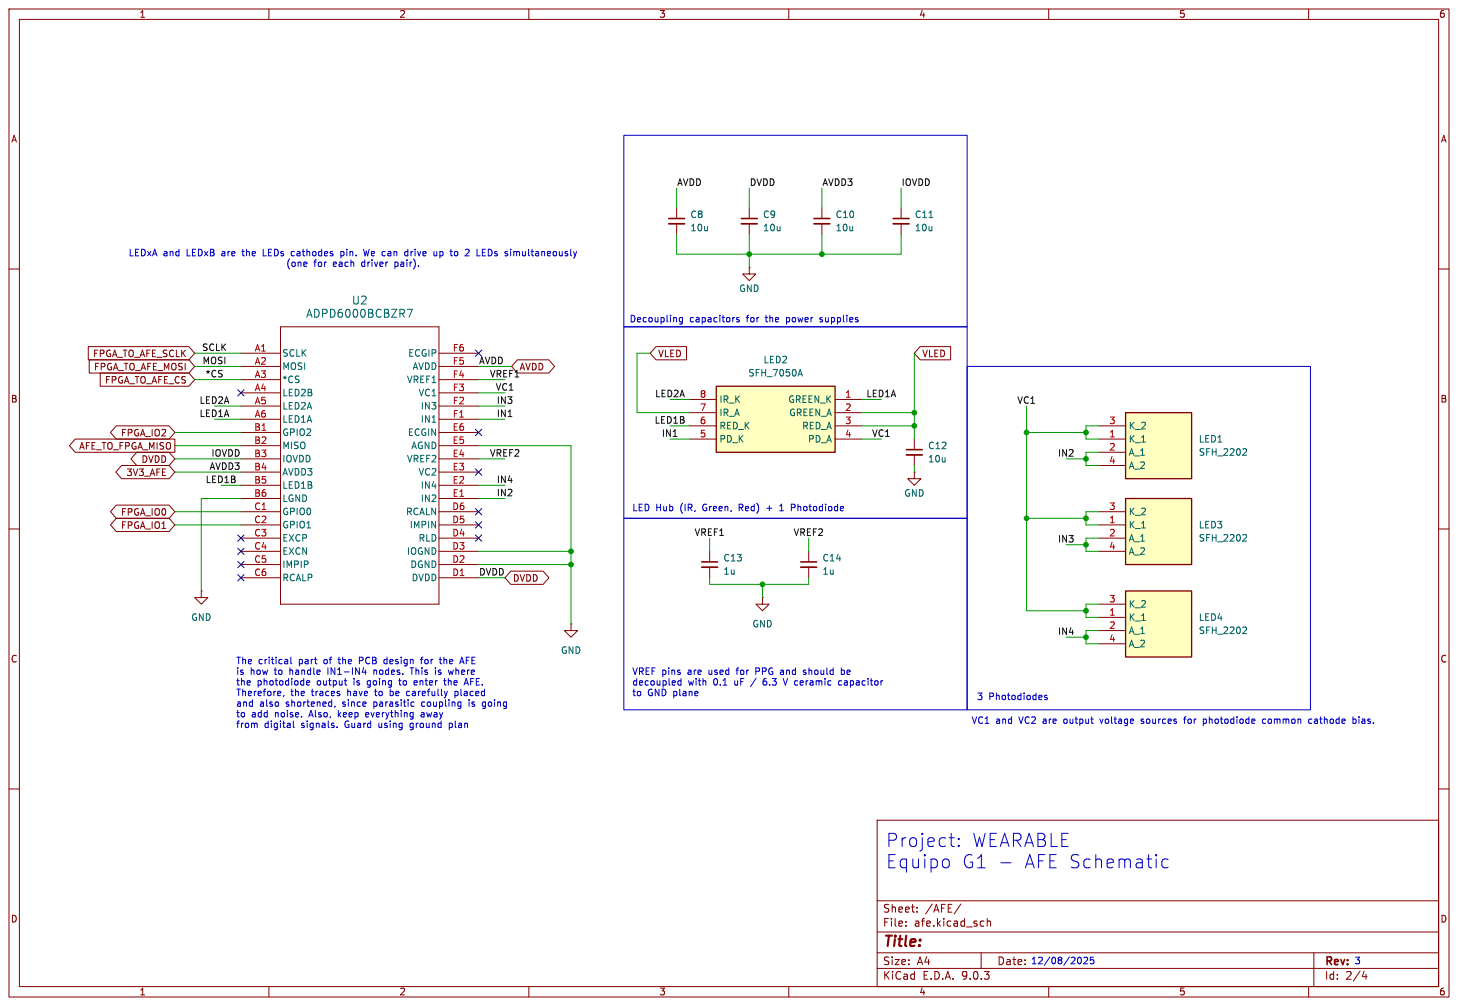
[picture p5: page 2]

Id: 2/4 Title: File: afe.kicad_sch Sheet: /AFE/

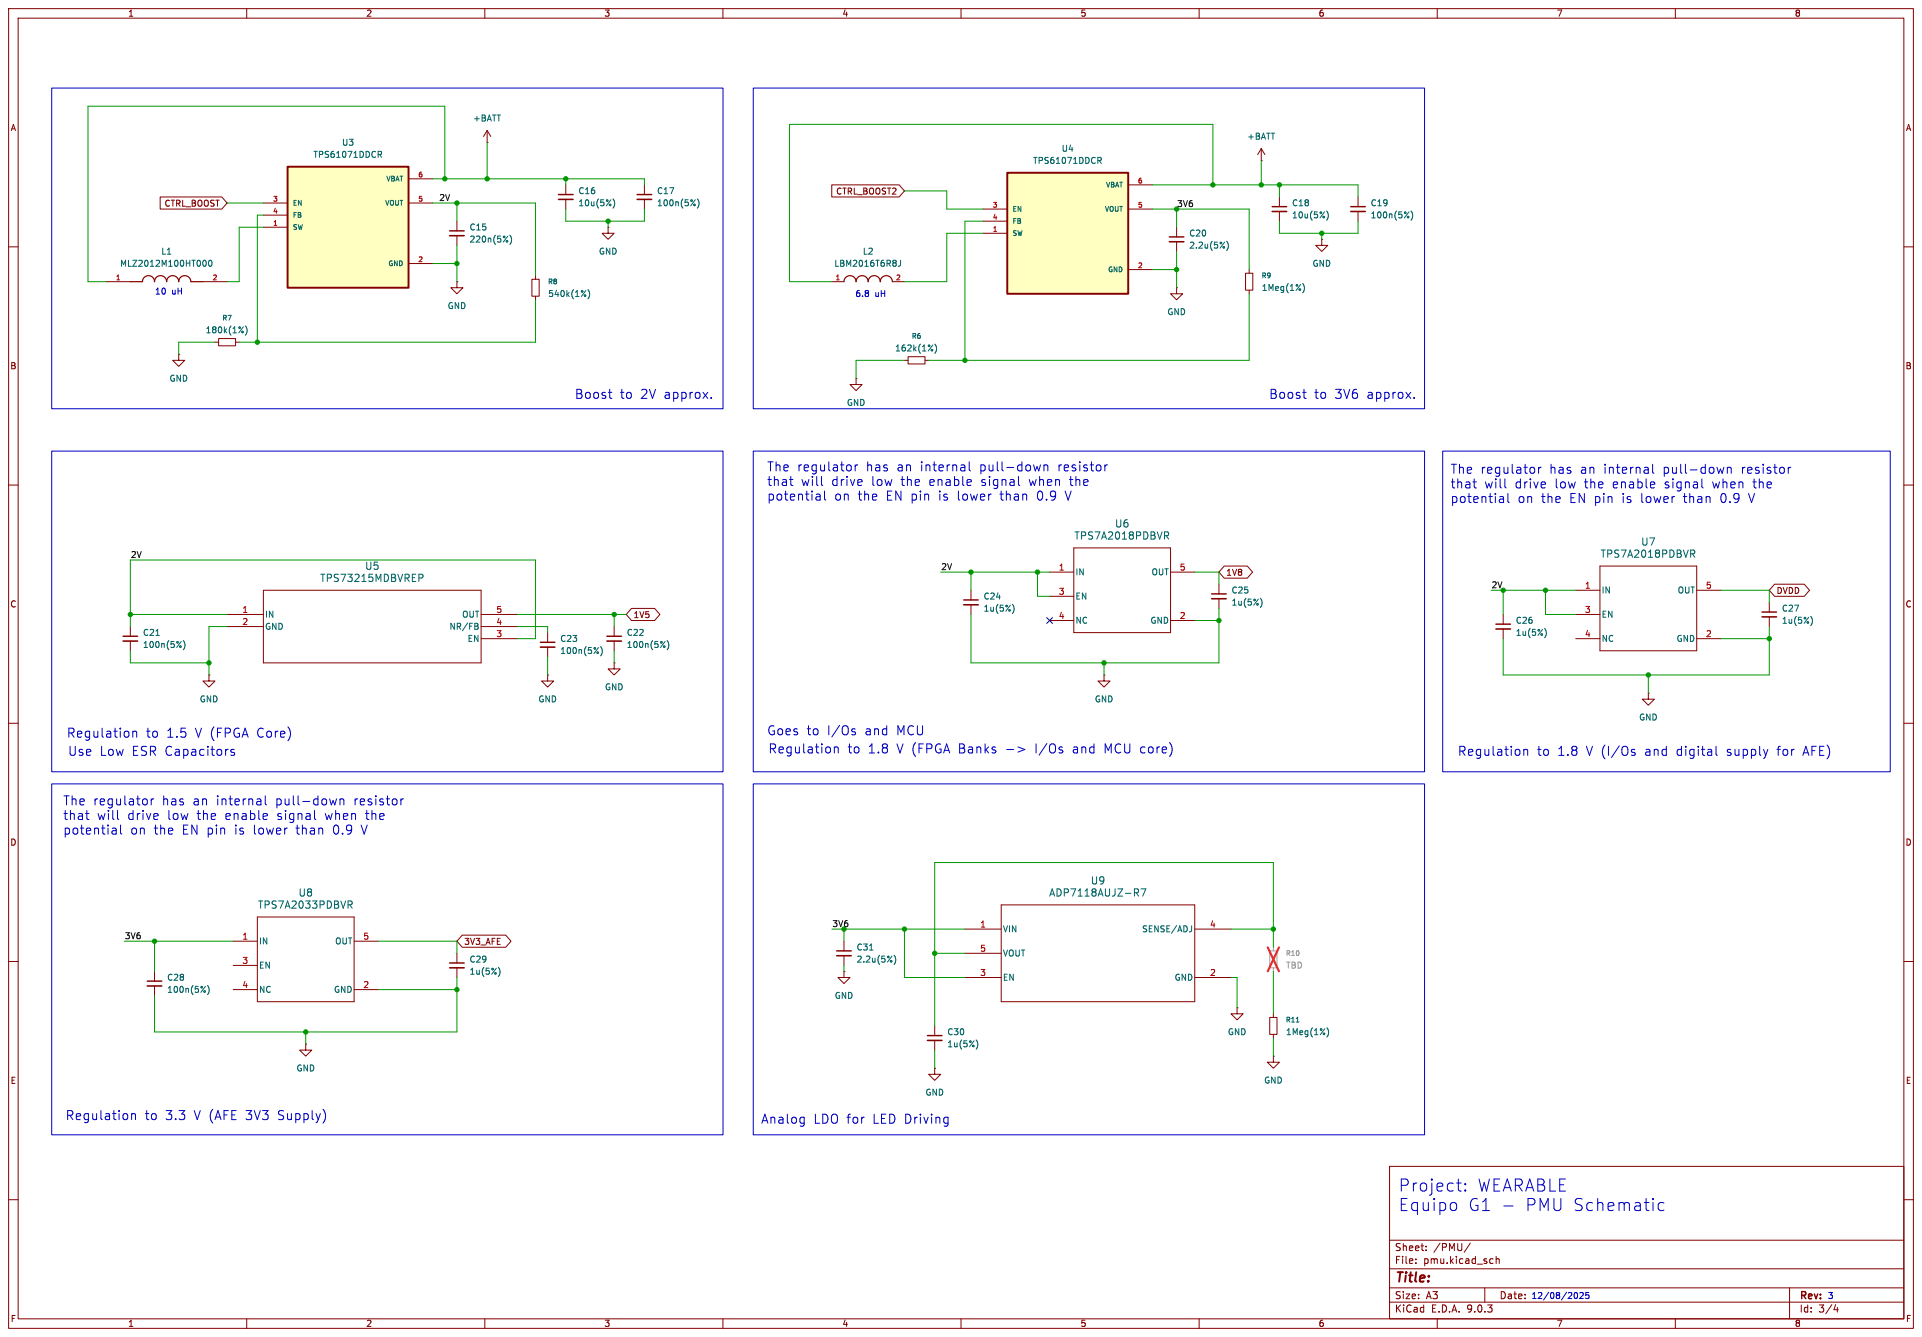
[picture p6: page 3]

6.8 uH Boost to 2V approx.

that will drive low the enable signal when the

Goes to I/Os and MCU

Analog LDO for LED Driving

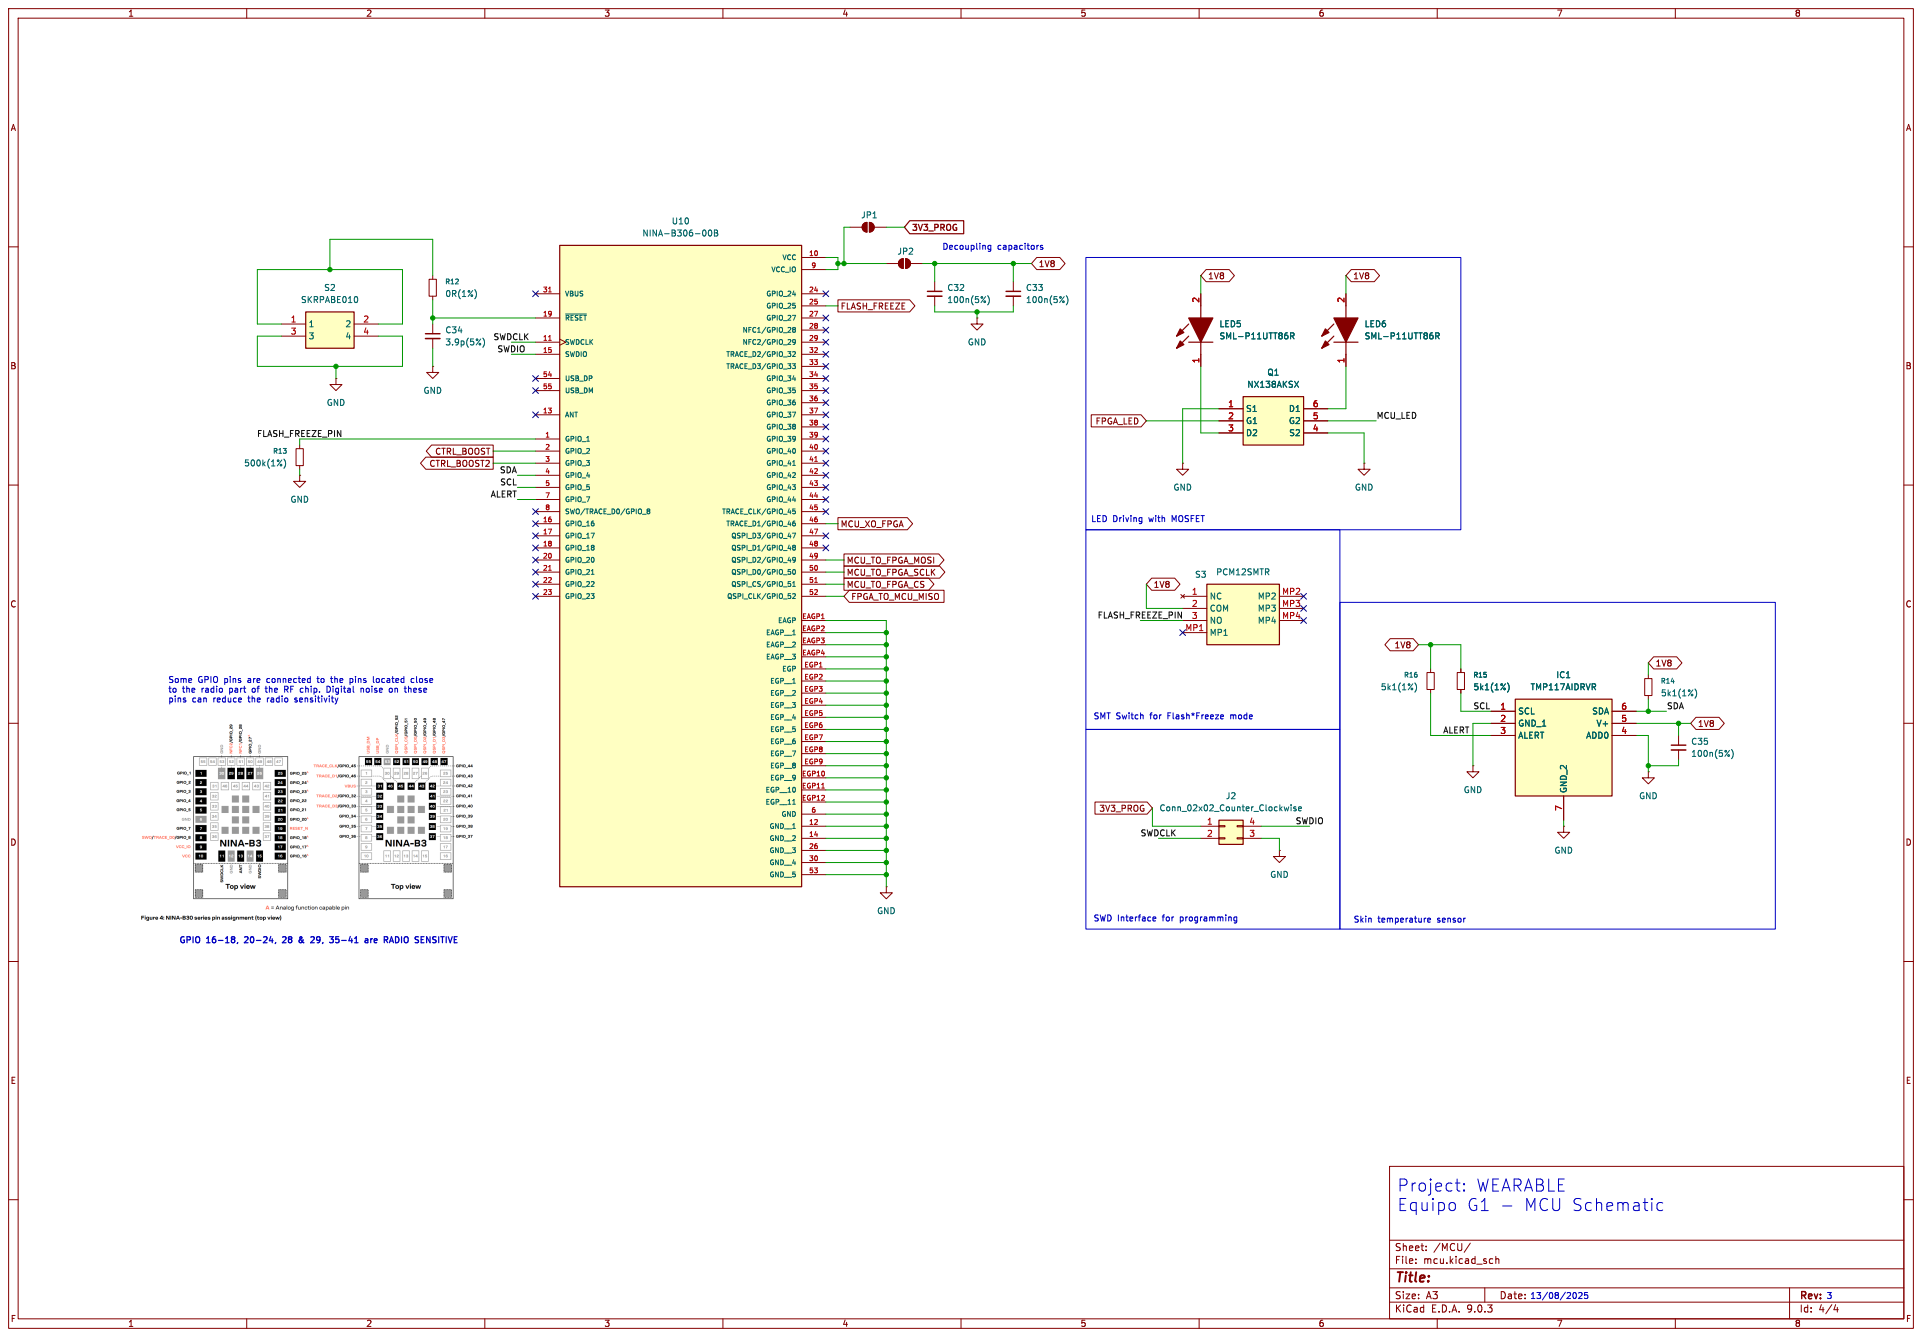
[picture p7: page 4]

to the radio part of the RF chip. Digital noise on these

Id: 4/4 Title: File: mcu.kicad_sch Sheet: /MCU/
