Ernesto311203/PE1_Wearable/PE_2_V1/ppg_data.h

#ifndef PPG_DATA_H
#define PPG_DATA_H

float ppg_data[1024] = {
  1826345.0f, 1827211.0f, 1828220.0f, 1829187.0f, 1830152.0f, 1831606.0f, 1832633.0f, 1834255.0f, 
  1835238.0f, 1836877.0f, 1837631.0f, 1838540.0f, 1838784.0f, 1839313.0f, 1839034.0f, 1839164.0f, 
  1839080.0f, 1839371.0f, 1839764.0f, 1839984.0f, 1840712.0f, 1841017.0f, 1841229.0f, 1841491.0f, 
  1841064.0f, 1841032.0f, 1840286.0f, 1840003.0f, 1839810.0f, 1839685.0f, 1839415.0f, 1838862.0f, 
  1838502.0f, 1838526.0f, 1838333.0f, 1838471.0f, 1838307.0f, 1838134.0f, 1837956.0f, 1837712.0f, 
  1837587.0f, 1837202.0f, 1837207.0f, 1837122.0f, 1837439.0f, 1837101.0f, 1837439.0f, 1836946.0f, 
  1837011.0f, 1837006.0f, 1836565.0f, 1836266.0f, 1835819.0f, 1835281.0f, 1835071.0f, 1834712.0f, 
  1834813.0f, 1834441.0f, 1834334.0f, 1834264.0f, 1833646.0f, 1833221.0f, 1832324.0f, 1831895.0f, 
  1831210.0f, 1831634.0f, 1832088.0f, 1832732.0f, 1833947.0f, 1835026.0f, 1835823.0f, 1836569.0f, 
  1837704.0f, 1838342.0f, 1839389.0f, 1840421.0f, 1841190.0f, 1842549.0f, 1843302.0f, 1843961.0f, 
  1844119.0f, 1844520.0f, 1844064.0f, 1844368.0f, 1844269.0f, 1844238.0f, 1844756.0f, 1844920.0f, 
  1845380.0f, 1845652.0f, 1845399.0f, 1844869.0f, 1844436.0f, 1844171.0f, 1843689.0f, 1843637.0f, 
  1843402.0f, 1842922.0f, 1843206.0f, 1843262.0f, 1842836.0f, 1842580.0f, 1841999.0f, 1841493.0f, 
  1841129.0f, 1840944.0f, 1840899.0f, 1840998.0f, 1841003.0f, 1841159.0f, 1841074.0f, 1841338.0f, 
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
  4087401.0f, 4087224.0f, 4086970.0f, 4086396.0f, 4086290.0f, 4086153.0f, 4085310.0f, 4085708.0f,
  4084993.0f, 4084954.0f, 4084767.0f, 4084735.0f, 4084657.0f, 4084325.0f, 4084028.0f, 4084170.0f,
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
};

#endif 
