Ernesto311203/PE1_Wearable/(commit log)

2025-08-13 Added schematics, footprints, symbols and 3D models. Worked on KiCAD 9
    [WearablePCB_v2.kicad_pcb, WearablePCB_v2.kicad_sch, afe.kicad_sch, mcu.kicad_sch, pmu.kicad_sch]
2025-08-13 Improving file tree
    [Proy1_test.kicad_pcb, Proy1_test.kicad_sch, WearablePCB_v2.kicad_pcb, WearablePCB_v2.kicad_sch, afe.kicad_sch, mcu.kicad_sch, pmu.kicad_sch]
2025-08-13 Moving folders to PCB directory for proper usage of environmental variables
2025-08-23 Se adicionan PCB secundario para prototipado y también PCB con board-to-board connector
    [WearablePCB_v2.kicad_pcb, WearablePCB_v2.kicad_sch, afe.kicad_sch, bom-JLCPCB Assembly Order.xls, bom.csv, designators.csv, mcu.kicad_sch, pmu.kicad_sch]
